jonathanw82/Hvac_controlReadme/media/diff.jpg

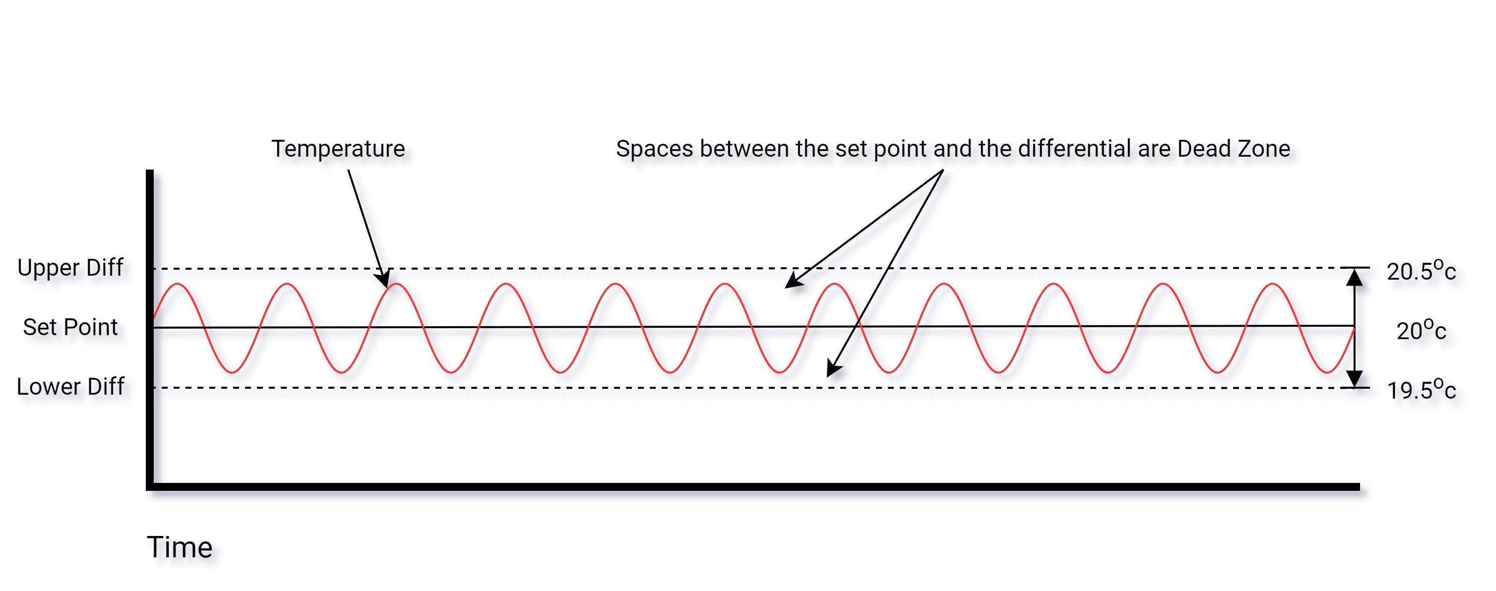
media/diff.jpg
