jonathanw82/Hvac_controlReadme/Hvac-api/todo.md

1 persistance in mqtt
<!-- 2 check controllino is sending data  -->
<!-- 3 get ip address from browser JS -->
4 pi touch screen

gunicon threadsgit
