jonathanw82/Hvac_controlReadme/(commit log)

2022-02-17 updated the wiring diagram to contain the multiplexer
2022-02-17 add sensor data to readme
